anyshake/scl3300-d01-evb/README.md

# scl3300-d01-evb
🍥 SCL3300-D01 accelerometer EVB with GNSS and EEPROM for testing purpose.
