anyshake/scl3300-d01-evb/hardware/scl3300-evb.csv

Reference | Qty | Value | DNP | Exclude from BOM | Exclude from Board | Footprint | Datasheet
BT1 | 1 | DMS3R3 |  |  |  | Battery:BatteryHolder_Seiko_MS621F
C1,C3,C5,C8,C9,C10,C11,C12,C13,C14,C16,C17,C18,C19,C20 | 15 | 0.1uF |  |  |  | Capacitor_SMD:C_0603_1608Metric
C2 | 1 | 10uF |  |  |  | Capacitor_Tantalum_SMD:CP_EIA-3528-12_Kemet-T
C4,C6 | 2 | 100pF |  |  |  | Capacitor_SMD:C_0603_1608Metric
C7 | 1 | 22uF |  |  |  | Capacitor_Tantalum_SMD:CP_EIA-3528-12_Kemet-T
C15 | 1 | 0.01uF |  |  |  | Capacitor_SMD:C_0603_1608Metric
D1,D2 | 2 | SS34 |  |  |  | Diode_SMD:D_SMA | https://www.vishay.com/docs/88751/ss32.pdf
D3 | 1 | SMAJ5.0A |  |  |  | Diode_SMD:D_SMA | https://www.littelfuse.com/media?itemid=75e32973-b177-4ee3-a0ff-cedaf1abdb93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
D4 | 1 | GREEN |  |  |  | LED_SMD:LED_0603_1608Metric
D5,D6,D7 | 3 | Yellow |  |  |  | LED_SMD:LED_0603_1608Metric
J1 | 1 | SMA |  |  |  | Connector_Coaxial:SMA_Amphenol_901-144_Vertical
J2 | 1 | STLINK |  |  |  | Connector_PinHeader_2.54mm:PinHeader_1x03_P2.54mm_Vertical
J3 | 1 | BOOT1 |  |  |  | Connector_PinHeader_2.54mm:PinHeader_1x03_P2.54mm_Vertical
J4 | 1 | BOOT0 |  |  |  | Connector_PinHeader_2.54mm:PinHeader_1x03_P2.54mm_Vertical
L1 | 1 | 1uH |  |  |  | Inductor_SMD:L_0603_1608Metric
P1 | 1 | USB_C_Receptacle_USB2.0_16P |  |  |  | Connector_USB:USB_C_Receptacle_HCTL_HC-TYPE-C-16P-01A | https://www.usb.org/sites/default/files/documents/usb_type-c.zip
R1,R2 | 2 | 5.1k |  |  |  | Resistor_SMD:R_0603_1608Metric
R3 | 1 | 0 |  |  |  | Resistor_SMD:R_0603_1608Metric
R4,R7,R8,R9 | 4 | 1k |  |  |  | Resistor_SMD:R_0603_1608Metric
R5,R6 | 2 | 4.7k |  |  |  | Resistor_SMD:R_0603_1608Metric
R10 | 1 | 10 |  |  |  | Resistor_SMD:R_0603_1608Metric
R11,R12,R13 | 3 | 10k |  |  |  | Resistor_SMD:R_0603_1608Metric
SW1 | 1 | RESET |  |  |  | Button_Switch_THT:SW_PUSH_6mm
SW2 | 1 | SAMPLERATE |  |  |  | Button_Switch_SMD:SW_DIP_SPSTx02_Slide_6.7x6.64mm_W8.61mm_P2.54mm_LowProfile
SW3 | 1 | OPTIONS |  |  |  | Button_Switch_SMD:SW_DIP_SPSTx03_Slide_6.7x9.18mm_W8.61mm_P2.54mm_LowProfile
TP1 | 1 | GNSS_RXD |  |  |  | TestPoint:TestPoint_Pad_D1.0mm
TP2 | 1 | GNSS_TXD |  |  |  | TestPoint:TestPoint_Pad_D1.0mm
TP3 | 1 | GNSS_1PPS |  |  |  | TestPoint:TestPoint_Pad_D1.0mm
TP4 | 1 | RXD |  |  |  | TestPoint:TestPoint_Pad_D1.0mm
TP5 | 1 | TXD |  |  |  | TestPoint:TestPoint_Pad_D1.0mm
U1 | 1 | NEO-M8M |  |  |  | RF_GPS:ublox_NEO | https://content.u-blox.com/sites/default/files/NEO-M8-FW3_DataSheet_UBX-15031086.pdf
U2 | 1 | AMS1117-3.3 |  |  |  | Package_TO_SOT_SMD:SOT-223-3_TabPin2 | http://www.advanced-monolithic.com/pdf/ds1117.pdf
U3 | 1 | AT24CS08-SSHM |  |  |  | Package_SO:SOIC-8_3.9x4.9mm_P1.27mm | http://ww1.microchip.com/downloads/en/DeviceDoc/Atmel-8766-SEEPROM-AT24CS04-08-Datasheet.pdf
U4 | 1 | SCL3300-D01 |  |  |  | evb:DFL-12_L8.6-W7.0-P1.00-LS7.6-BL | https://www.murata.com/~/media/webrenewal/products/sensor/pdf/datasheet/datasheet_scl3300-d01.ashx
U5 | 1 | CH340N |  |  |  | Package_SO:JEITA_SOIC-8_3.9x4.9mm_P1.27mm | https://aitendo3.sakura.ne.jp/aitendo_data/product_img/ic/inteface/CH340N/ch340n.pdf
U6 | 1 | STM32F103C8Tx |  |  |  | Package_QFP:LQFP-48_7x7mm_P0.5mm | https://www.st.com/resource/en/datasheet/stm32f103c8.pdf
U7 | 1 | SSD1306 |  |  |  | Explorer:SSD1306 | https://cdn-shop.adafruit.com/datasheets/SSD1306.pdf
Y1 | 1 | SG-8002CA 8M-PCML0 |  |  |  | Oscillator:Oscillator_SMD_SeikoEpson_SG8002CA-4Pin_7.0x5.0mm | https://support.epson.biz/td/api/doc_check.php?mode=dl&lang=en&Parts=SG-8002DC
