anyshake/scl3300-d01-evb/haradware/scl3300-evb.pdf

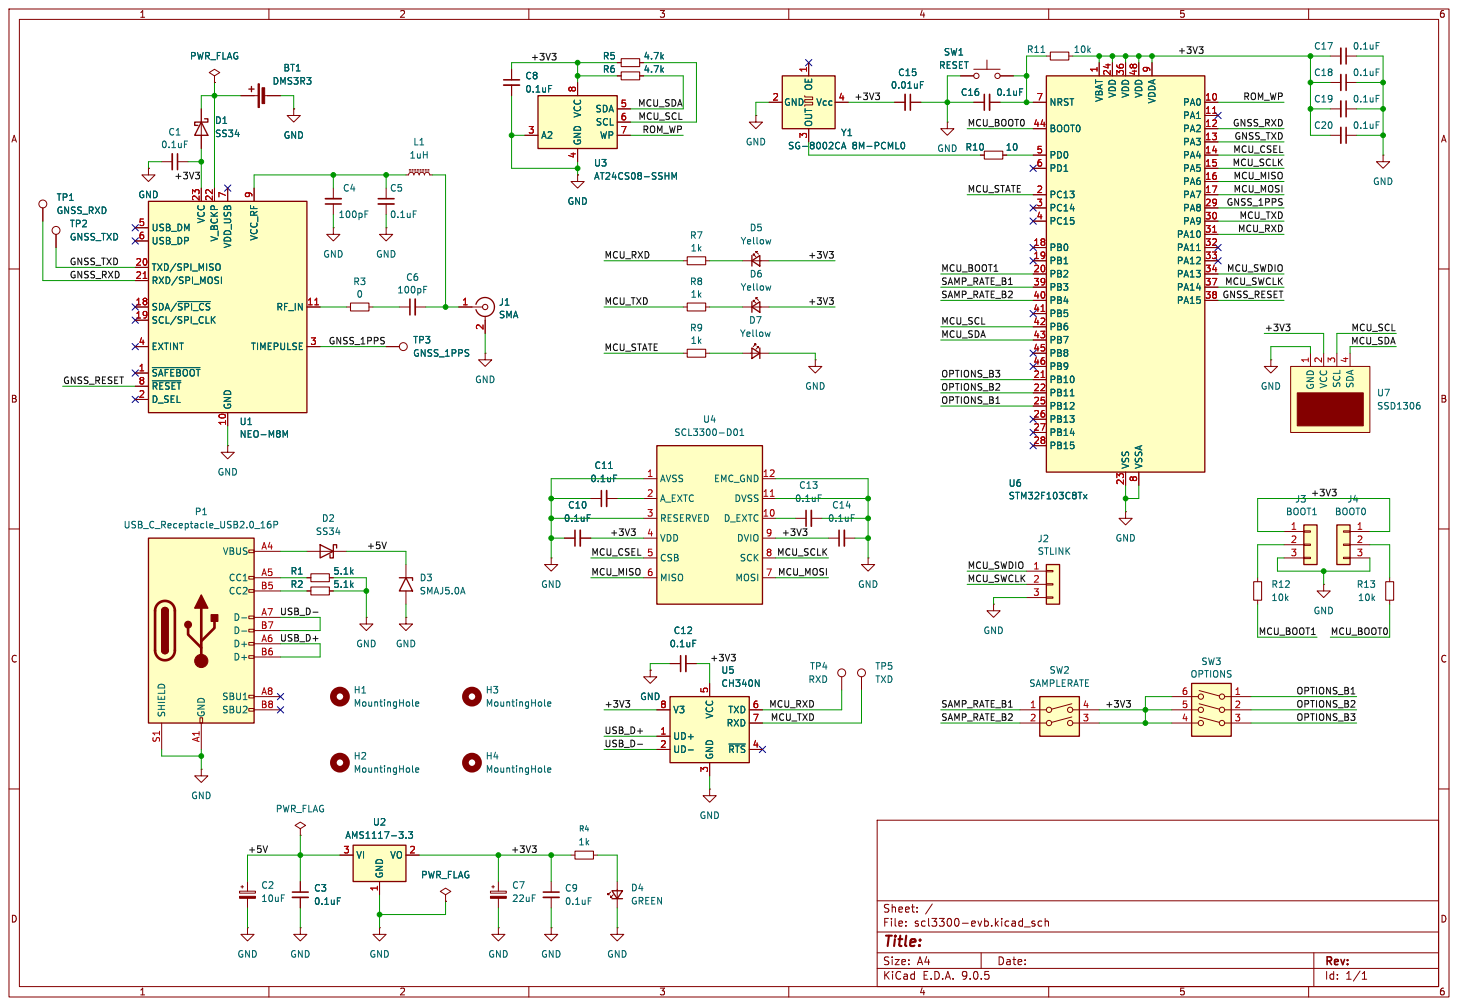
[picture p1: page 1]

1 VDD 24 VDD 36 VSS 23 VDD 48 VSSA

4 SDA 5 SCL 6 WP 7 U3AT24CS08-SSHM

Id: 1/1 Title: File: scl3300-evb.kicad_sch Sheet: /
