anyshake/scl3300-d01-evb/haradware/scl3300-evb.kicad_pcb

## KiCad design haradware/scl3300-evb.kicad_pcb (2026-07-05)

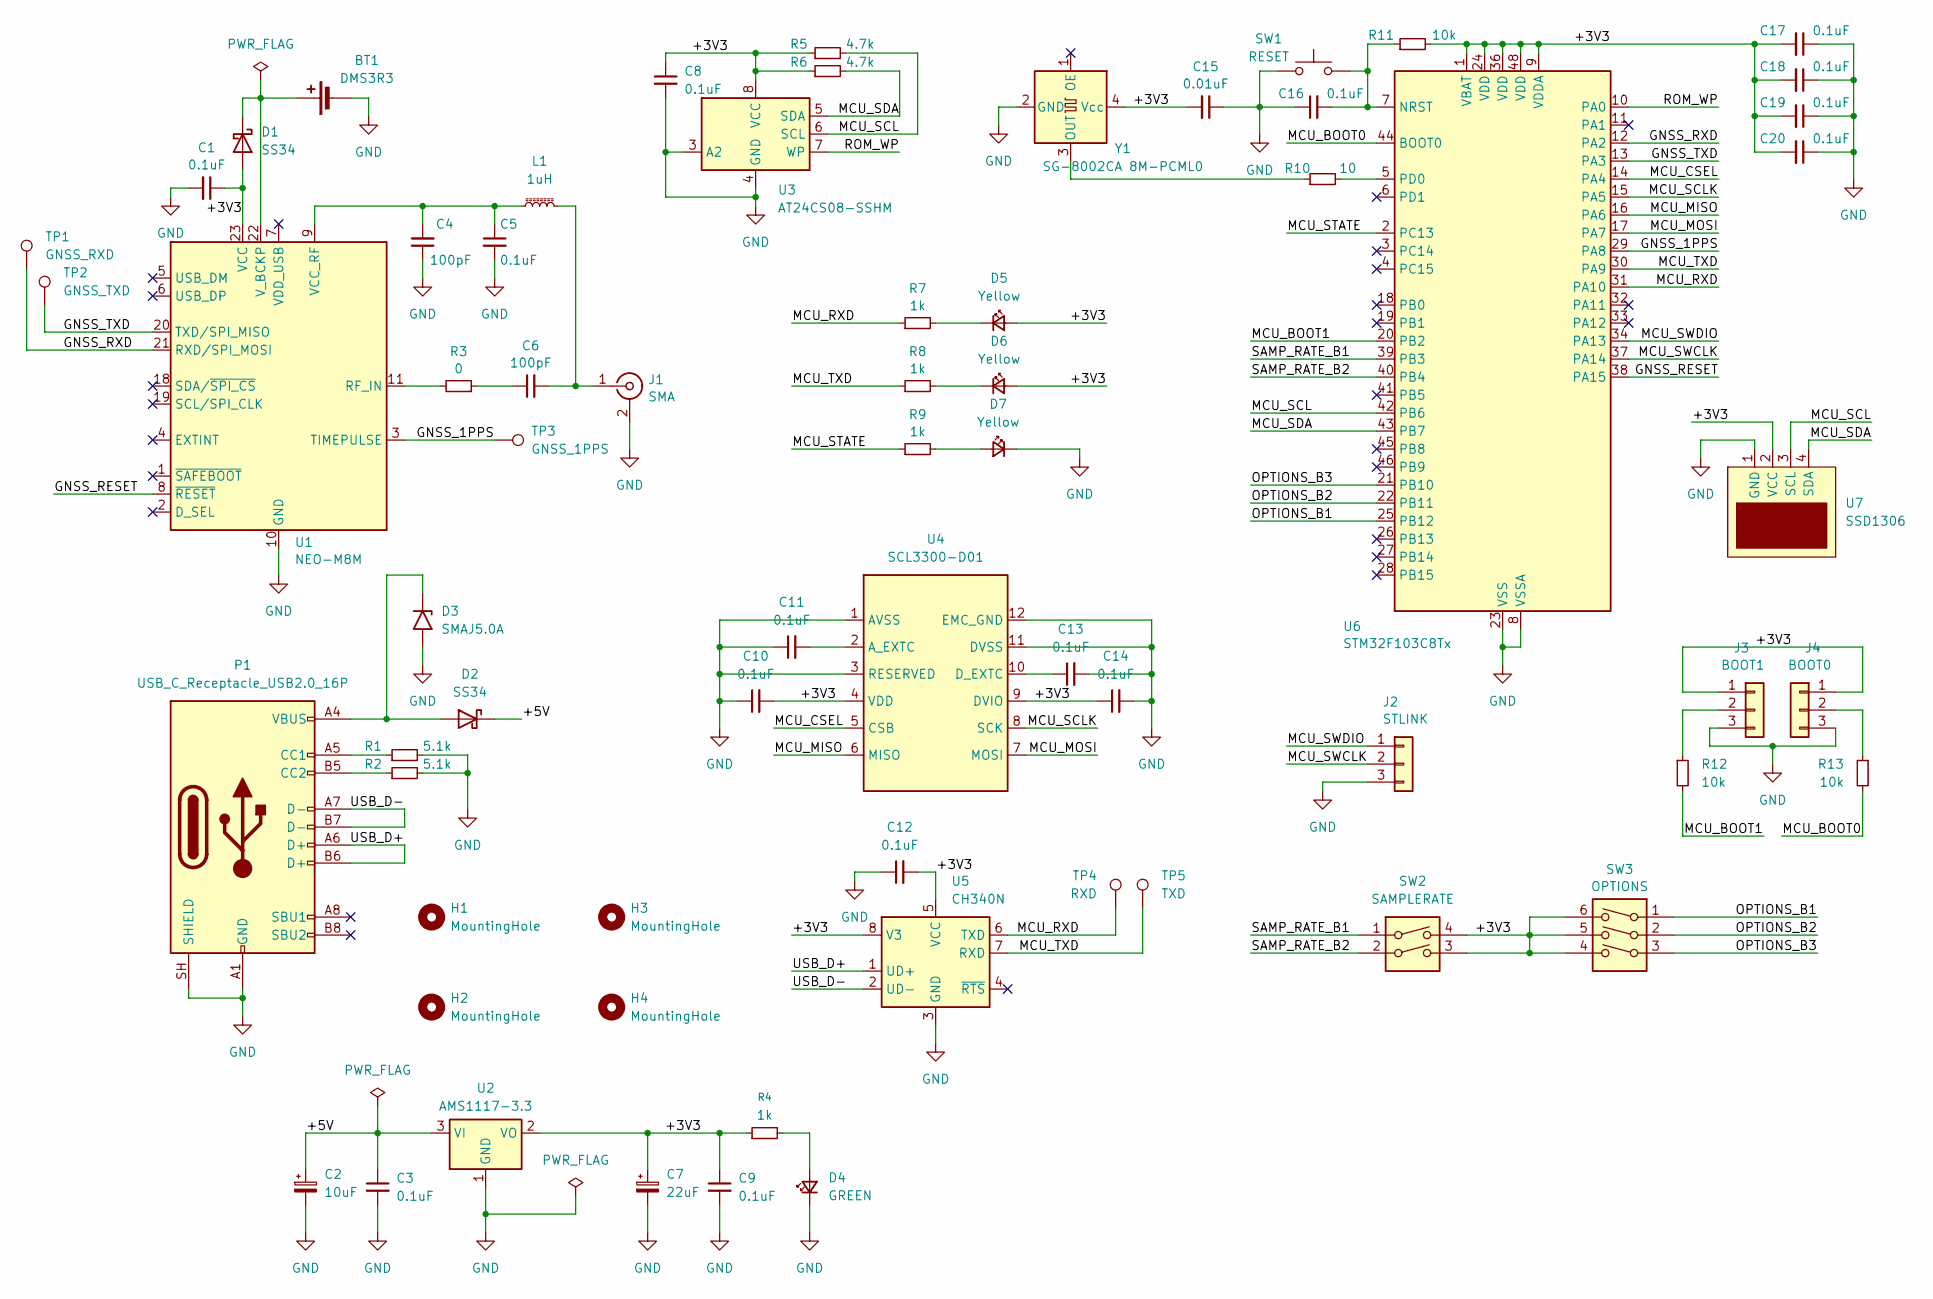
[picture p2: schematic scl3300-evb.kicad_sch]

Parts:
BT1: DMS3R3; BatteryHolder_Seiko_MS621F
C1, C3, C5, C8, C9, C10, C11, C12, C13, C14, C16, C17, C18, C19, C20: 0.1uF; C_0603_1608Metric
C2: 10uF; CP_EIA-3528-12_Kemet-T
C4, C6: 100pF; C_0603_1608Metric
C7: 22uF; CP_EIA-3528-12_Kemet-T
C15: 0.01uF; C_0603_1608Metric
D1, D2: SS34; D_SMA
D3: SMAJ5.0A; D_SMA
D4: GREEN; LED_0603_1608Metric
D5, D6, D7: Yellow; LED_0603_1608Metric
H1, H2, H3, H4: MountingHole; MountingHole_2.2mm_M2_DIN965_Pad
J1: SMA; SMA_Amphenol_901-144_Vertical
J2: STLINK; PinHeader_1x03_P2.54mm_Vertical
J3: BOOT1; PinHeader_1x03_P2.54mm_Vertical
J4: BOOT0; PinHeader_1x03_P2.54mm_Vertical
L1: 1uH; L_0603_1608Metric
P1: USB_C_Receptacle_USB2.0_16P; USB_C_Receptacle_HCTL_HC-TYPE-C-16P-01A
R1, R2: 5.1k; R_0603_1608Metric
R3: 0; R_0603_1608Metric
R4, R7, R8, R9: 1k; R_0603_1608Metric
R5, R6: 4.7k; R_0603_1608Metric
R10: 10; R_0603_1608Metric
R11, R12, R13: 10k; R_0603_1608Metric
SW1: RESET; SW_PUSH_6mm
SW2: SAMPLERATE; SW_DIP_SPSTx02_Slide_6.7x6.64mm_W8.61mm_P2.54mm_LowProfile
SW3: OPTIONS; SW_DIP_SPSTx03_Slide_6.7x9.18mm_W8.61mm_P2.54mm_LowProfile
TP1: GNSS_RXD; TestPoint_Pad_D1.0mm
TP2: GNSS_TXD; TestPoint_Pad_D1.0mm
TP3: GNSS_1PPS; TestPoint_Pad_D1.0mm
TP4: RXD; TestPoint_Pad_D1.0mm
TP5: TXD; TestPoint_Pad_D1.0mm
U1: NEO-M8M; ublox_NEO
U2: AMS1117-3.3; SOT-223-3_TabPin2
U3: AT24CS08-SSHM; SOIC-8_3.9x4.9mm_P1.27mm
U4: SCL3300-D01; DFL-12_L8.6-W7.0-P1.00-LS7.6-BL
U5: CH340N; JEITA_SOIC-8_3.9x4.9mm_P1.27mm
U6: STM32F103C8Tx; LQFP-48_7x7mm_P0.5mm
U7: SSD1306
Y1: SG-8002CA 8M-PCML0; Oscillator_SMD_SeikoEpson_SG8002CA-4Pin_7.0x5.0mm

Connections:
/+3V3: C1.1, C7.1, C8.1, C9.1, C10.2, C12.2, C14.1, C15.2, C17.2, C18.2, C19.2, C20.2, D1.2 (A), D5.2 (A), D6.2 (A), J3.1, J4.1, R4.1, R5.1, R6.1, R11.2, SW2.3, SW2.4, SW3.4, SW3.5, SW3.6, U1.23 (VCC), U2.2 (VO), U3.8 (VCC), U4.4 (VDD), U4.9 (DVIO), U5.5 (VCC), U5.8 (V3), U6.1 (VBAT), U6.9 (VDDA), U6.24 (VDD), U6.36 (VDD), U6.48 (VDD), U7.2 (VCC), Y1.4 (Vcc)
/+5V: C2.1, C3.1, D2.1 (K), U2.3 (VI)
/GNSS_1PPS: TP3.1 (1_1), U1.3 (TIMEPULSE), U6.29 (PA8)
/GNSS_RESET: U1.8 (~RESET), U6.38 (PA15)
/GNSS_RXD: TP1.1 (1_1), U1.21 (RXD/SPI_MOSI), U6.12 (PA2)
/GNSS_TXD: TP2.1 (1_1), U1.20 (TXD/SPI_MISO), U6.13 (PA3)
/MCU_BOOT0: R13.2, U6.44 (BOOT0)
/MCU_BOOT1: R12.2, U6.20 (PB2)
/MCU_CSEL: U4.5 (CSB), U6.14 (PA4)
/MCU_MISO: U4.6 (MISO), U6.16 (PA6)
/MCU_MOSI: U4.7 (MOSI), U6.17 (PA7)
/MCU_RXD: R7.1, TP4.1 (1_1), U5.6 (TXD), U6.31 (PA10)
/MCU_SCL: R5.2, U3.6 (SCL), U6.42 (PB6), U7.3 (SCL)
/MCU_SCLK: U4.8 (SCK), U6.15 (PA5)
/MCU_SDA: R6.2, U3.5 (SDA), U6.43 (PB7), U7.4 (SDA)
/MCU_STATE: R9.1, U6.2 (PC13)
/MCU_SWCLK: J2.2, U6.37 (PA14)
/MCU_SWDIO: J2.1, U6.34 (PA13)
/MCU_TXD: R8.1, TP5.1 (1_1), U5.7 (RXD), U6.30 (PA9)
/OPTIONS_B1: SW3.1, U6.25 (PB12)
/OPTIONS_B2: SW3.2, U6.22 (PB11)
/OPTIONS_B3: SW3.3, U6.21 (PB10)
/ROM_WP: U3.7 (WP), U6.10 (PA0)
/SAMP_RATE_B1: SW2.1, U6.39 (PB3)
/SAMP_RATE_B2: SW2.2, U6.40 (PB4)
/USB_D+: P1.A6 (D+), P1.B6 (D+), U5.1 (UD+)
/USB_D-: P1.A7 (D-), P1.B7 (D-), U5.2 (UD-)
GND: BT1.2 (-), C1.2, C2.2, C3.2, C4.1, C5.2, C7.2, C8.2, C9.2, C10.1, C11.1, C12.1, C13.2, C14.2, C15.1, C16.1, C17.1, C18.1, C19.1, C20.1, D3.2 (A2), D4.1 (K), D7.1 (K), J1.2 (Ext), J2.3, J3.3, J4.3, P1.A1 (GND), P1.A12 (GND), P1.B1 (GND), P1.B12 (GND), P1.SH (SHIELD), R1.2, R2.2, SW1.1, U1.10 (GND), U1.12 (GND), U1.13 (GND), U1.24 (GND), U2.1 (GND), U3.3 (A2), U3.4 (GND), U4.1 (AVSS), U4.3 (RESERVED), U4.11 (DVSS), U4.12 (EMC_GND), U5.3 (GND), U6.8 (VSSA), U6.23 (VSS), U6.35 (VSS), U6.47 (VSS), U7.1 (GND), Y1.2 (GND)
unnamed: BT1.1 (+), D1.1 (K), U1.22 (V_BCKP)
unnamed: C6.1, R3.1
unnamed: D2.2 (A), D3.1 (A1), P1.A4 (VBUS), P1.A9 (VBUS), P1.B4 (VBUS), P1.B9 (VBUS)
unnamed: D4.2 (A), R4.2
unnamed: D5.1 (K), R7.2
unnamed: D6.1 (K), R8.2
unnamed: D7.2 (A), R9.2
unnamed: C6.2, J1.1 (In), L1.2
unnamed: J3.2, R12.1
unnamed: J4.2, R13.1
unnamed: P1.A5 (CC1), R1.1
unnamed: P1.B5 (CC2), R2.1
unnamed: R3.2, U1.11 (RF_IN)
unnamed: C4.2, C5.1, L1.1, U1.9 (VCC_RF)
unnamed: C11.2, U4.2 (A_EXTC)
unnamed: C13.1, U4.10 (D_EXTC)
unnamed: C16.2, R11.1, SW1.2, U6.7 (NRST)
unnamed: R10.2, U6.5 (PD0)
unnamed: R10.1, Y1.3 (OUT)

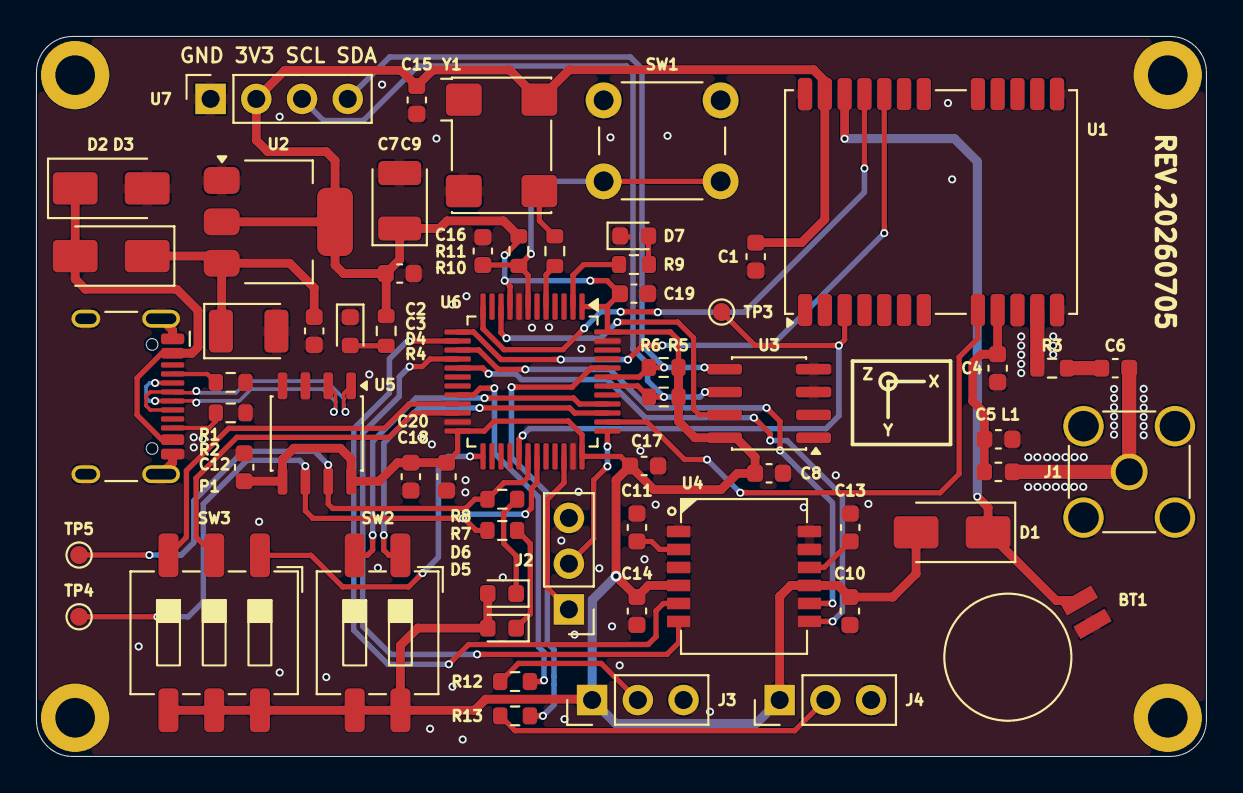
[picture p3: board scl3300-evb.kicad_pcb from above]

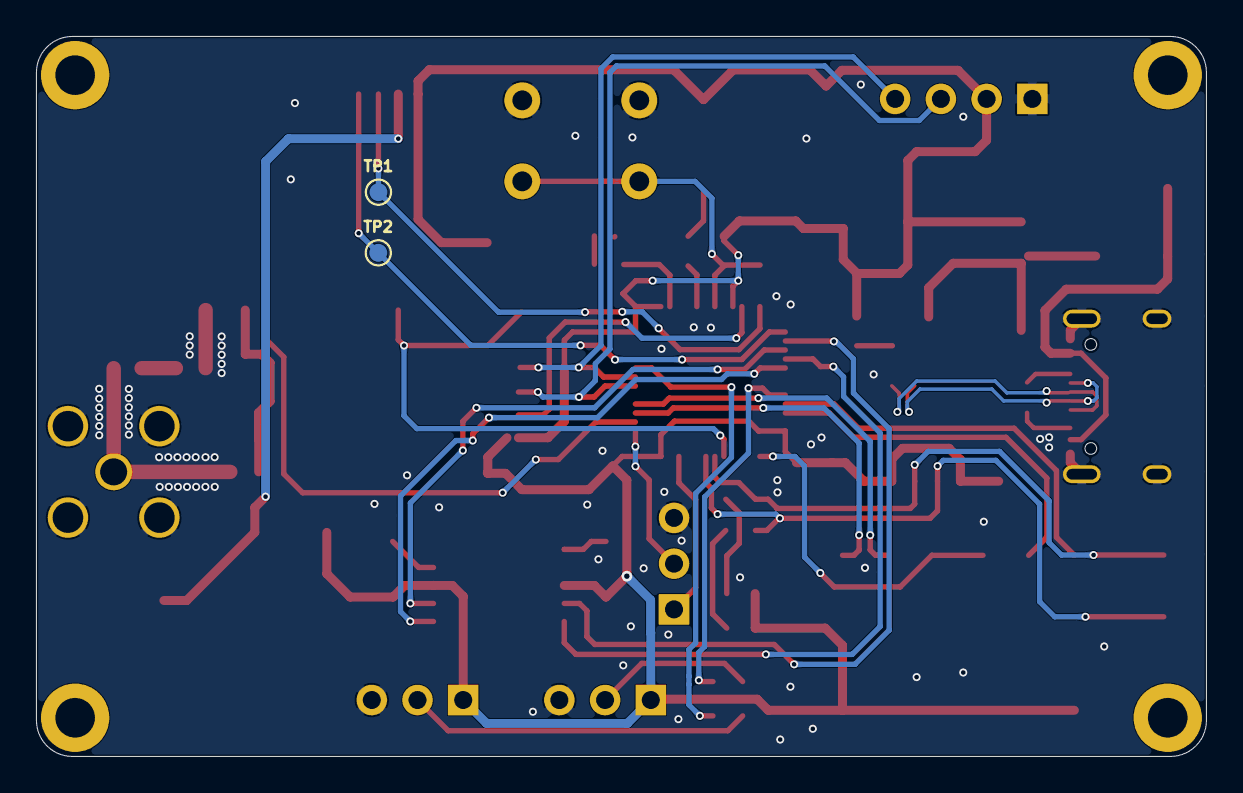
[picture p4: board scl3300-evb.kicad_pcb from below]

Board: 2 copper layers, 65.0 x 40.0 mm, 67 parts (2 on the bottom side), 47 nets.
