anyshake/scl3300-d01-evb/firmware/Utils/Src/uart2.c

#include "Utils/Inc/uart2.h"

static mcu_utils_uart2_buffer_t uart2_rx_buffer;
static uint8_t uart2_dma_rx_char;

void HAL_UARTEx_RxEventCallback(UART_HandleTypeDef* huart, uint16_t len) {
    if (huart->Instance == USART2) {
        if (len != 0) {
            uint16_t next_head = (uart2_rx_buffer.head + 1) % MCU_UTILS_UART2_BUFFER_SIZE;
            if (next_head != uart2_rx_buffer.tail) {
                uart2_rx_buffer.buffer[uart2_rx_buffer.head] = uart2_dma_rx_char;
                uart2_rx_buffer.head = next_head;
            }
        }
        if (HAL_UARTEx_ReceiveToIdle_DMA(&huart2, &uart2_dma_rx_char, sizeof(uart2_dma_rx_char)) == HAL_OK) {
            __HAL_DMA_DISABLE_IT(huart2.hdmarx, DMA_IT_HT);
        }
    }
}

void mcu_utils_uart2_init(uint32_t baudrate, bool is_rtos) {
    if (HAL_UART_GetState(&huart2) == HAL_UART_STATE_RESET) {
        huart2.Instance = USART2;
        huart2.Init.BaudRate = baudrate;
        huart2.Init.WordLength = UART_WORDLENGTH_8B;
        huart2.Init.StopBits = UART_STOPBITS_1;
        huart2.Init.Parity = UART_PARITY_NONE;
        huart2.Init.Mode = UART_MODE_TX_RX;
        huart2.Init.HwFlowCtl = UART_HWCONTROL_NONE;
        huart2.Init.OverSampling = UART_OVERSAMPLING_16;
        HAL_UART_Init(&huart2);

        mcu_utils_uart2_flush();

        HAL_NVIC_SetPriority(DMA1_Channel6_IRQn, 5, 0);
        HAL_NVIC_EnableIRQ(DMA1_Channel6_IRQn);
        __HAL_UART_ENABLE_IT(&huart2, UART_IT_IDLE);
        if (HAL_UARTEx_ReceiveToIdle_DMA(&huart2, &uart2_dma_rx_char, sizeof(uart2_dma_rx_char)) == HAL_OK) {
            __HAL_DMA_DISABLE_IT(huart2.hdmarx, DMA_IT_HT);
        }
    }

    mcu_utils_delay_ms(100, is_rtos);
}

void mcu_utils_uart2_write(uint8_t* tx_data, uint16_t tx_len, bool wait) {
    HAL_UART_Transmit(&huart2, tx_data, tx_len, 1000);
}

void mcu_utils_uart2_flush(void) {
    uart2_rx_buffer.tail = uart2_rx_buffer.head;
}

void mcu_utils_uart2_end(void) {
    if (HAL_UART_GetState(&huart2) != HAL_UART_STATE_RESET) {
        HAL_UART_DMAStop(&huart2);
        __HAL_UART_DISABLE_IT(&huart2, UART_IT_IDLE);
        HAL_NVIC_DisableIRQ(DMA1_Channel6_IRQn);
        HAL_UART_DeInit(&huart2);
        mcu_utils_uart2_flush();
    }
}

bool mcu_utils_uart2_hasdata(void) {
    return uart2_rx_buffer.head != uart2_rx_buffer.tail;
}

uint8_t mcu_utils_uart2_read(void) {
    if (uart2_rx_buffer.head == uart2_rx_buffer.tail) {
        return 0;
    }

    uint8_t data = uart2_rx_buffer.buffer[uart2_rx_buffer.tail];
    uart2_rx_buffer.tail = (uart2_rx_buffer.tail + 1) % MCU_UTILS_UART2_BUFFER_SIZE;
    return data;
}

int32_t mcu_utils_uart2_read_buf(uint8_t* dat, uint16_t len) {
    if (len == 0) {
        return 0;
    }

    uint16_t available = uart2_rx_buffer.head >= uart2_rx_buffer.tail
                             ? uart2_rx_buffer.head - uart2_rx_buffer.tail
                             : MCU_UTILS_UART2_BUFFER_SIZE - uart2_rx_buffer.tail + uart2_rx_buffer.head;

    uint16_t to_read = (len <= available) ? len : available;
    for (uint16_t i = 0; i < to_read; i++) {
        dat[i] = uart2_rx_buffer.buffer[uart2_rx_buffer.tail];
        uart2_rx_buffer.tail = (uart2_rx_buffer.tail + 1) % MCU_UTILS_UART2_BUFFER_SIZE;
    }

    return to_read;
}

int32_t mcu_utils_uart2_read_line(uint8_t* str, uint16_t len) {
    if (len == 0) {
        return 0;
    }

    uint16_t tmp_tail = uart2_rx_buffer.tail;
    for (uint16_t count = 0; tmp_tail != uart2_rx_buffer.head;) {
        uint8_t ch = uart2_rx_buffer.buffer[tmp_tail];
        tmp_tail = (tmp_tail + 1) % MCU_UTILS_UART2_BUFFER_SIZE;

        if (count + 1 >= len) {
            while (ch != '\n' && tmp_tail != uart2_rx_buffer.head) {
                ch = uart2_rx_buffer.buffer[tmp_tail];
                tmp_tail = (tmp_tail + 1) % MCU_UTILS_UART2_BUFFER_SIZE;
            }
            uart2_rx_buffer.tail = tmp_tail;
            return -1;
        }

        str[count] = ch;
        count++;

        if (ch == '\n') {
            uart2_rx_buffer.tail = tmp_tail;
            return count;
        }
    }

    return 0;
}
