anyshake/scl3300-d01-evb/firmware/Utils/Inc/delay.h

#ifndef __ANYSHAKE_MCU_UTILS_DELAY_H
#define __ANYSHAKE_MCU_UTILS_DELAY_H

#include <stdbool.h>
#include <stdint.h>

#include "cmsis_os2.h"
#include "stm32f1xx_hal.h"

void mcu_utils_delay_ms(uint32_t ms, bool is_rtos);
void mcu_utils_delay_us(uint32_t us);

#endif
