anyshake/scl3300-d01-evb/(commit log)

2026-04-19 chore: rename PCB folder
    [scl3300-evb-B_Cu.gbr, scl3300-evb-B_Mask.gbr, scl3300-evb-B_Paste.gbr, scl3300-evb-B_Silkscreen.gbr, scl3300-evb-Edge_Cuts.gbr, scl3300-evb-F_Cu.gbr, scl3300-evb-F_Mask.gbr, scl3300-evb-F_Paste.gbr]
2026-04-19 chore: repository init
    [scl3300-evb-B_Cu.gbr, scl3300-evb-B_Mask.gbr, scl3300-evb-B_Paste.gbr, scl3300-evb-B_Silkscreen.gbr, scl3300-evb-Edge_Cuts.gbr, scl3300-evb-F_Cu.gbr, scl3300-evb-F_Mask.gbr, scl3300-evb-F_Paste.gbr]
2026-07-05 fix: SCL3300-D01 footprint
2026-10-10 feat: Enhance GNSS and sensor integration
    - Added GNSS location handling in data packet encoding.
    - Introduced new functions for peripheral initialization including GNSS and sensor setup.
    - Implemented reading accelerometer data from SCL3300.
    - Improved system time management with new utility functions for uptime and Unix time retrieval.
    - Updated GPIO utility to support input pull-down mode.
    - Enhanced UART2 communication with improved DMA handling.
    - Added a script for linker flags to optimize binary size.
    - Updated platformio.ini for GNSS model configuration and linker script integration.
2026-10-11 feat: add SCA3300 sensor support
